chujoii/sumowar/README.org

#+OPTIONS: LaTeX:t          Do the right thing automatically (MathJax)
#+OPTIONS: LaTeX:dvipng     Force using dvipng images
#+OPTIONS: LaTeX:nil        Do not process LaTeX fragments at all
#+OPTIONS: LaTeX:verbatim   Verbatim export, for jsMath or so
#+ATTR_HTML: width="3in"

README.org --- description

Copyright (C) 2012 Roman V. Prikhodchenko

Author: Roman V. Prikhodchenko <chujoii@gmail.com>

  This file is part of sumowar.

  sumowar is free software: you can redistribute it and/or modify
  it under the terms of the GNU General Public License as published by
  the Free Software Foundation, either version 3 of the License, or
  (at your option) any later version.

  sumowar is distributed in the hope that it will be useful,
  but WITHOUT ANY WARRANTY; without even the implied warranty of
  MERCHANTABILITY or FITNESS FOR A PARTICULAR PURPOSE.  See the
  GNU General Public License for more details.

  You should have received a copy of the GNU General Public License
  along with sumowar.  If not, see <http://www.gnu.org/licenses/>.

* Keywords:
robot auto 

* Usage:
use it

* History:
Version 0.1 was created at 2013-05(May)-31

* Dependences:
  
* Description

** Название
sumowar [[./drawings/sumowar.png][sumowar ambigramm by chujoii]]
** Шасси

Основа робота - шасси с 4 ведущими и одновременно рулевыми
колёсами. Угол поворота каждого колеса задаётся серводвигателем (180
градусов). Поэтому робот может двигаться в любом направлении по
плоскости, и с любым радиусом разворота.

[[./drawings/chassis.png][sumowar chassis]]

Необходимо учитывать, что стандартные сервы (по крайней мере те
которые есть у меня) могут разворачивать только на 180 градусов, а в
некоторых случаях требуется реверсировать направление вращения
двигателей. Формулы для расчётов:

[[./drawings/motion.png][sumowar motion]]

*** Колёса

Колёса собраны по второй схеме:
[[./drawings/wheel.png][sumowar wheel]]
  
Из следующих компонентов:
[[./img/14020014.jpg][sumowar wheel components]]

- Крепёж скоба металлическая однолапковая D=25mm
- Подшипник с тонкими обоймами: от рулевой стойки 2108-09
  (C 2108-3401120-03) (размеры, как у 6805ZZ + пластиковая вставка)
- Алюминиевый профиль квадратный, наружный размер 15x15мм,
  внутренний размер 12x12мм (подходит для двигателя)
- 12V 200RPM Mini DC Metal Gear Motor Model:N20 (Sanyo) вот здесь я
  промахнулся с выбором - нужно было покупать 5-вольтовые двигатели
  и к ним drv8830
- покрышка для колеса подходящего диаметра

Внутрь подшипника устанавливается алюминиевый профиль и всё
закрепляется эпоксидкой (в проветриваемом помещении и в перчатках).
Самое сложное - сделать конструкцию соосной (не двигая головой,
добиться чтобы при вращении подшипника отражения внутри алюминиевого
профиля не наклонялись).

[[./img/14020037.jpg][sumowar wheel + epoxy + profile]]

*** Поворотный механизм
 
Скоба, маленький подшипник и пишущий узел от фломастера.

[[./img/14030007.jpg][sumowar bracer + ball bearing + felt-tip pen]]
  
На пластиковом основании (размеры отверстий соответствуют
пластиковому конструктору) крепятся подшипники.

[[./img/14030014.jpg][sumowar plate + ball bearing]]

С другой стороны приклеил держатели от банок с водой (розовые) и
подходящего диаметра крышки (синие) - они играют роль сервосейверов,
установщиков нуля (чтобы выставить поворот всех колёс одинаково) и
стоек на которых крепятся серводвигатели.

[[./img/14030006.jpg][sumowar bottle lid]]
  
Собираем всё вместе: 

[[./img/14030024.jpg][sumowar servo bracing]]

Припаиваем провода и керамический конденсатор (например k10-176
0.068uF U=50-100V), приклеиваем скобы на скотч, а также заклеиваем винт,
чтобы он не прокручивался в пишущем узле от фломастера.

*** Шасси в сборе

[[./img/14030032.jpg][sumowar wheel wire]]

Собираем всё вместе. На фотографии видны зажимы для бумаги - тоже
своеобразные сервосейверы - они с одной стороны приклеены к
покрышке, хорошо держатся на D-образном срезе оси двигателя, и
должны прощёлкивать при превышении усилия (однако, как оказалось
прощёлкивают даже при незначительном усилии и поэтому были сняты)

[[./img/14030037.jpg][sumowar chasis with servosaver]]

** Датчик линии

В качестве датчика линии - камера от оптической мыши.

Включена подсветка поверхности для видеокамеры из мыши. В качестве
объектива используется линза от CD-привода и дверной глазок.

[[./img/14050009.jpg][sumowar backlight]]

** Переворачиватель

Для участия в битве роботов установлен переворачиватель
противника. Пластиковая пластинка согнута под острым углом и играет
роль отвала (ножа). Внутрь полученного отвала установлен целофановый
пакет. При приближении противника лодочный насос (12v) нагнетает
воздух в целофановый пакет, он надувается примерно за секунду и
переворачивает робота противника. К сожалению, обычно, после этого
пакет лопается - нужно добавить датчик давления для контроля процесса
и отсос воздуха для многоразового использования. Эксперименты
проводились на пятилитровой банке с водой (по условиям конкурса вес
робота не более 3кг).

[[./drawings/obstacle.png][sumowar obstacle]]

** Вилочный подъёмник
  
Помимо переворачивалки предполагался вилочный подъёмник, однако
программная часть не была завершена вовремя и подъёмник не
установили.
[[./drawings/high-rise.png][sumowar high-rise]]

Одна из функций вилочного подъёмника - создание частичной
невидимости.

[[./drawings/invisible-and-military-dummy.png][sumowar invisible and dummy]]

** Первый слой
Вот как выглядит первый слой после сборки
(странности: фотография развёрнута):

[[./img/14050005.jpg][sumowar first level]]

- чёрная плата в середине - видеокамера из оптической мыши (там был
  ещё микроконтроллер для предварительной обработки изображения, но
  он не влез по размерам и был отрезан)
- самая верхняя и самая нижняя платы - L293 (знаю что не очень
  хорошие, но что было то и использовал)
- справа из под видеокамеры выглядывают конденсаторы для
  серводвигателей с самовосстанавливающимися предохранителями на
  200мА
- слева виден расширитель портов pcf8574 (выбор направления вращения
  для колёс) и шлейф (шина i2c + 1-wire + interrupt + reset)

* calculation
from http://www.robotshop.com/ca/learning-center/dynamic-tools.html

| INPUT                   |          |
|-------------------------+----------|
| Total mass of robot:    | 3 kg     |
| Number of drive motors: | 4 [#]    |
| Radius of drive wheel:  | 0.015 M  |
| Velocity of robot:      | 2 m/s    |
| Maximum incline:        | 30 [deg] |
| Supply voltage:         | 12 [V]   |
| Desired acceleration:   | 0.2 m/s2 |
| Desired operating time: | 15 min   |
| Total efficiency:       | 65 [%]   |

| OUTPUT  (per drive motor) |                                             |
|---------------------------+---------------------------------------------|
| Angular Velocity          | 133.33 rad/s                                |
| Torque*                   | 0.088356  Nm, 0.90067 kgf-cm, 12.511 ozf-in |
| Total Power               | 11.781 W                                    |
| Maximum current           | 0.98173 [A]                                 |
| Battery Pack              | 0.98173 [AH]                                |

| DC/V | RPM/min | torque kg.cm | Reduction ratio(1:00) |
|------+---------+--------------+-----------------------|
| 12V  |     300 |          0.6 |                   100 |
| 12V  |     200 |            1 |                   150 |
| 12V  |     100 |            2 |                   298 |
|      |         |              |                       |

* TechnoRoboCom
[2014-05-29] робот "sumowar" принял участие в конкурсе технологических
решений роботизированных устройств [[http://vk.com/club70185285][«TechnoRoboCom»]] .

[[./img/1auZE-fbeDQ.jpg][sumowar presentation]]

[[./img/LDUvZ1TbqBs.jpg][sumowar sumo]]

Один из основных этапов проекта - участие в конкурсе TechnoRoboCom
организованном Студенческим Бизнес Инкубатором (СБИ ПетрГУ).

В процессе работы в 2014 (второй семестр) году к проекту
присоединились студенты.

участники и их роли в проекте:

| Ф.И.О.                       | факультет                    | специальность (1013-2014 годы)                                                              | роль в проекте                                                                                                    |
|------------------------------+------------------------------+---------------------------------------------------------------------------------------------+-------------------------------------------------------------------------------------------------------------------|
| Бирюков Алексей Сергеевич    | физико-технический факультет | Теплоэнергетика и теплотехника курс:1 21115                                                 | создание платы драйвера шагового двигателя, вилочный погрузчик с отвалом, "Презентация"                           |
| Платонов Александр Сергеевич | физико-технический факультет | Теплоэнергетика и теплотехника курс:1 21115                                                 | создание платы драйвера шагового двигателя, вилочный погрузчик с отвалом, "Презентация"                           |
| Угрюмов Андрей Николаевич    | физико-технический факультет | Электропривод и автоматика промышленных установок и технологических комплексов курс:5 21505 | алгоритм "Битва роботизированных устройств", "Презентация"                                                        |
| Приходченко Роман Викторович | физико-технический факультет | Старший преподаватель                                                                       | всё остальное (закупки, механика, электроника, hal, алгоритм "Презентация", алгоритм "Трек", алгоритм "Лабиринт") |

** что он умеет делать

обсуждение на странице [[http://roboforum.ru/forum10/topic14343.html]]

Он ещё только учится :)

Подготовка отдельных модулей к соревнованию длилась около года.
Сборка была ужасной процедурой и заняла неделю. За оставшиеся два
дня были протестированы только алгоритмы движения колёс и обработка
изображения с видеокамеры.

На конкурсе работали только следующие режимы:

- Презентация.  Робот, не поворачиваясь вокруг оси, рисует звёздочку
  - проезжает по лучику и возвращается в центр.
    Потом вращается вокруг точек, которые генерируются в цикле.
    Координаты центров вращения расположены равномерно снаружи
    и внутри робота.
- Отслеживание линии. Робот распознаёт линию видеокамерой,
     проезжает по ней около метра и теряет её :( Буду дорабатывать
     алгоритм позже.
- Битва роботов. Не успел приделать датчики, алгоритм и вилочный
   подъёмник, поэтому был включён режим "презентации" с рисованием
   звёздочки и вращением. Робот выиграл два боя, случайно вытолкав
   противника с ринга во время танца  :oops:
  
Сейчас робота забрали на выставку :( 
Поэтому доделываю недоделки:  сканирующую систему для построения карты
и поиска противников.

*** Видео
  
  [[https://www.youtube.com/watch?v=cjYzR39-Q50]]
  выступление самовара с 2:26

  [[http://vk.com/video-60211626_169279477]]

* выводы

1. чтобы размещать платы стопками (как книги в шкафу) необходимо:
   
   печатные платы нужно делать с входами на одной стороне и выходами
   на другой стороне.
   
   совершенно недопустимо делать разъёмы на всех сторонах

2. на каждом этаже внутренней конструкции робота необходимо иметь
   "автономное" питание (свои GND, +5, +12)

3. каждый этаж должен соединяться со следующим ОДНИМ шлейфом (возможно
   составленным из проводов разного диаметра) чтобы можно было легко
   разъединять этажи

4. между устройствами (особенно между этажами) желательно использовать
   одну шину данных (i2c, 1-wire, ...), а не подключать каждое
   устройство напрямую к микроконтроллеру

5. ножки драйверов двигателей прижимать ?килоомным резистором к земле,
   а не оставлять болтаться как есть или подтягивать к питанию - чтобы
   при старте (в ту секунду между включением питания и инициализацией
   ножек микроконтроллера) двигатели не включались на полную скорость
