chujoii/sumowar/src/xbee.org

xbee.org --- how to use Xbee radio module; setup to rotation scanner

Copyright (C) 2013 Roman V. Prikhodchenko

Author: Roman V. Prikhodchenko <chujoii@gmail.com>

  This file is part of markerway.

  markerway is free software: you can redistribute it and/or modify
  it under the terms of the GNU General Public License as published by
  the Free Software Foundation, either version 3 of the License, or
  (at your option) any later version.

  markerway is distributed in the hope that it will be useful,
  but WITHOUT ANY WARRANTY; without even the implied warranty of
  MERCHANTABILITY or FITNESS FOR A PARTICULAR PURPOSE.  See the
  GNU General Public License for more details.

  You should have received a copy of the GNU General Public License
  along with markerway.  If not, see <http://www.gnu.org/licenses/>.

* connection to computer (FT232RL)

| ftdi | lilypad - zigbee |
|------+------------------|
| gnd  | gnd              |
| rx   | rx (not crossed) |
| tx   | tx (not crossed) |
| -    | 3.3 (external)   |

Air, Earth - Xbee Series 2

* AT-command

+++ 

** example 
   ATDT 1F<CR>
   | AT prefix | ASCII command | Space (optional) | Parameter (optional, HEX) | Carriage Return ('\r', 0x0D) |
   |-----------+---------------+------------------+---------------------------+------------------------------|
   | AT        | DT            |                  | 1F                        | <CR>                         |

| command | parameter | description                                                                               |
|---------+-----------+-------------------------------------------------------------------------------------------|
| ATBD    |         3 | read/write serial port speed 0:1200 1:2400 2:4800 3:9600 4:19200 5:38400 6:57600 7:115200 |
| ATID    |           | network identifier                                                                        |
| ---ATMY |           | node identifier MY sets the 16bit address                                                 |
| ATDH    |           | destination node identifier 64bit address                                                 |
| ATDL    |           | destination node identifier 64bit address                                                 |
|         |           |                                                                                           |
| ATND    |           | detect all nodes in network (обнаружить все узлы сети)                                    |
|         |           |                                                                                           |
| ATCN    |           | leave command mode                                                                        |
| ATWR    |           | write settings to firmware                                                                |

* string format
  Unix format Line feed LF ('\n', 0x0A)
  DOS format carriage_return + Line_feed CR+LF ('\r\n', 0x0D 0x0A)
  
  picocom --omap lfcr,delbs --imap crcrlf,bsdel --echo --baud 9600 /dev/ttyUSB0
  exit: C-a C-x 

* simple echo AT-mode
** earth configure
   "Coordinator AT"
   +++
   
   ATSH
   >>>> 123456
   
   ATSL
   >>>> ABCDEF12
   
   ;; ATID 3 ???????
   ATDH 123456
   ATDL ABCDEF01
   ATWR
   ATCN
   
** air configure
   "Router/end device AT"
   +++
   
   ATSH
   >>>> 123456
   
   ATSL
   >>>> ABCDEF01
   
   ;; ATID 7 ???????
   ATDH 123456
   ATDL ABCDEF12
   ATWR
   ATCN

   At air need connect "rx" and "tx"

** earth test work
   print "test" (without +++)

* adc API-mode

** earth configure
   "Coordinator API"

** air configure
   "Router/end device AT"
   
   +++
   ATD0 2 ;; enable ADC in pin D0
   ;; ATIR 0 ;; not need

** air testing from PC

   | command | description                                                                   |
   |---------+-------------------------------------------------------------------------------|
   | +++     | start                                                                         |
   |         |                                                                               |
   | ATD4 5  | LED "on"                                                                      |
   |         |                                                                               |
   | ATAC    | apply port state                                                              |
   |         |                                                                               |
   | ATIS    | read from photodiode dark current from ADC                                    |
   | > 01    | 1 byte ;; number of samples (in packet)                                       |
   | > 0010  | 2 byte ;; (Digital channel mask of) all digital pins reported on as list      |
   | > 01    | 1 byte ;; ADC D0 (analog channel mask of) all analog pins reported on as list |
   | > 0010  | 2 byte ;; D4 pin is on                                                        |
   | > 022D  | 2 byte ;; #x3FF == 1.2V   #x022D readed => (/ (* #x022D 1.2) #x3FF) = 0.65 V  |
   |         |                                                                               |
   | ATD4 4  | LED "off"                                                                     |
   |         |                                                                               |
   | ATAC    | apply port state                                                              |
   |         |                                                                               |
   | ATIS    | read from photodiode dark current from ADC                                    |
   | > 01    | 1 byte ;; number of samples (in packet)                                       |
   | > 0010  | 2 byte ;; (Digital channel mask of) all digital pins reported on as list      |
   | > 01    | 1 byte ;; ADC D0 (analog channel mask of) all analog pins reported on as list |
   | > 0000  | 2 byte ;; DO pin is off                                                       |
   | > 00CC  | 2 byte ;; #x3FF == 1.2V   #x00CC readed => (/ (* #x00CC 1.2) #x3FF) = 0.24 V  |
   |         |                                                                               |

* ultrasonic
  need use "Change Detection Sampling"

  | command | parameter | description                                                                                                                             |
  |---------+-----------+-----------------------------------------------------------------------------------------------------------------------------------------|
  | IR + IT |           | for sample rate                                                                                                                         |
  | IC      |           | to enable change detection on the input lines                                                                                           |
  | IA      |           | parameter controls permissions for other modules to order this module to change the states of its output lines.                         |
  | Tn + Dn |           | parameter (n in 0–7) sets timeout values for output lines whose values are set through I/O line passing (not through the IO parameter). |
  | PT      |           | parameter is a common timeout value for both analog outputs. (PWM)                                                                      |
  | IU      |           | parameter controls what happens to line state packets.                                                                                  |
