chujoii/sumowar/src/markerway/markerway-header.org

#+OPTIONS: LaTeX:t          Do the right thing automatically (MathJax)
#+OPTIONS: LaTeX:dvipng     Force using dvipng images
#+OPTIONS: LaTeX:nil        Do not process LaTeX fragments at all
#+OPTIONS: LaTeX:verbatim   Verbatim export, for jsMath or so
#+ATTR_HTML: width="10in"

% org-export-with-LaTeX-fragments

README.org --- description

Copyright (C) 2012 Roman V. Prikhodchenko

Author: Roman V. Prikhodchenko <chujoii@gmail.com>

  This file is part of markerway.

  markerway is free software: you can redistribute it and/or modify
  it under the terms of the GNU General Public License as published by
  the Free Software Foundation, either version 3 of the License, or
  (at your option) any later version.

  markerway is distributed in the hope that it will be useful,
  but WITHOUT ANY WARRANTY; without even the implied warranty of
  MERCHANTABILITY or FITNESS FOR A PARTICULAR PURPOSE.  See the
  GNU General Public License for more details.

  You should have received a copy of the GNU General Public License
  along with markerway.  If not, see <http://www.gnu.org/licenses/>.

* Keywords:
  robot auto 

* Description:

* Usage:
  use it

* Code:

У меня функции для работы с аппаратурой почти готовы.
Вам их писать не нужно. Ваша задача: сумо (бой роботов).

Вот список функций для получения данных и для отдачи команд роботу:

int set_wheels_straight (int angle, int desirable_linear_velocity)
{
   /*
   устанавливает движение робота по прямой линии.
   под углом angle = 0 .. 360, причём 90 градусов - движение вперёд.
   со скоростью desirable_linear_velocity = -255 .. 255.
   */
}

int set_wheels_rotate (int xt, int yt, int desirable_angular_velocity)
{
   /*
   x, y - координаты точки вращения относительно центра робота
          в ?миллиметрах? (миллиметры - потому, что
	  величины будут целыми,
	  сохранится большая точность,
	  размер максимального поля 32767мм~33метра - хватает для трассы).
   desirable_angular_velocity угловая скорость вращения.
   */
}

в любой момент вы можете прочитать массивы отсканированного
пространства, данные массивы обновляются автоматически (по прерываниям):

#define ir_hi_angle = 9 // углы в градусах
#define ir_hi_dimension = 40 // размер массива сейчас не известен (ещё не завершён) шаг двигателя 9 градусов -> 360/9 = 40
int ir_hi[ir_hi_dimension]; // данные инфракрасного датчика на башне

#define us_hi_angle = 9
#define us_hi_dimension = 40 
int us_hi[ir_hi_dimension]; // данные ультразвукового датчика на башне

#define us_lo_angle = 15
#define us_lo_dimension = 12 // размер массива сейчас не известен (нужны эксперименты) угол ультразвукового излучателя 15 градусов -> 180/15 = 12 или 24 для точности
int us_lo[ir_lo_dimension]; // данные ультразвукового датчика на бампере

#define line_sensor_dimension = 4
int line_sensor[line_sensor_dimension]; // инфракрасные датчики линии под каждым из четырёх колёс

#define button_sensor_dimension = 8
int button_sensor[button_sensor_dimension]; // кнопки по бокам робота с каждой стороны по две штуки

/*
        перед
        0    1

  7                 2
левый             правый 
борт              борт
  6                 3

        5    4
         зад

*/

// дополнительные функции:

int min_index(int p[], int dimension)
{
   /*
   вычисляет номер минимального элемента массива 
   */
}

int cycle_delay_ms = 10; // милисекунды

// у робота будет два оружия - отвал (спереди) и переворачивалка (сзади)
int bulldozer_blade(int f)
{
   поднять отвал с усилием f (0..255).
   результатом будет реальная высота поднятия (0..1023).
   очень сильно сажает батарейку - подняли, вытолкали за линию и выключили. если не удалось поднять за ~10 секунд, то тоже выключили. выключать нужно программно: bulldozer_blade(0);
}

int bulldozer_turn(int f)
{
   перевернуть с усилием f (0..255)
   результатом будет 0 (датчик отсутствует)
   очень сильно сажает батарейку - перевернули подержали так примерно ~10 секунд и выключили программно: bulldozer_turn(0);
}

если что забыл, то спрашивайте

У вас была правильно разделена программа на функции.
вот как примерно будет выглядеть ваша функция атаки (объявление предыдущих функций и констант не нужно, они уже есть):

void robosumo(){
   // найдём ближайшую цель - в реальности не сработает потому, что ближайшей целью скорее всего окажется нога зрителя
   int enemy_angle = min_index(ir_hi, ir_hi_dimension) * ir_hi_angle; // номер минимального элемента умножим на шаг в градусах получим угол расположения противника
   int speed = 255;
   int counter; // счётчик в цикле

   boolean all_white = true; //

   if (button_sensor[0] || button_sensor[1]){
      // он попался! раз коснулся переднего отвала
      bulldozer_blade(255); // не забудьте засечь время и выключить через ~10 секунд!
   }
   if (button_sensor[5] || button_sensor[6]){
      // он попался! раз коснулся задней переворачивалки
      bulldozer_turn(255); // не забудьте засечь время и выключить через ~10 секунд!
   }

   for (counter = 0; counter< line_sensor_dimension; counter++){
      // в цикле проверяем датчики линии под колёсами
      if (itisblack(line_sensor[counter])) { // если не дотягивает до белого, то оно чёрное
         all_white = false;
      }
   }   

   if (all_white) {
      // если все датчики линии показывают белый свет, то разворачиваемся (толкать лучше отвалом)
      // но закомментировано потому что одновременное движение и вращение описываются другими формулами (Трохоида - например удлинённая циклоида)
      // вы сперва повернитесь (например 3 секунды и только потом двигайтесь)
      // set_wheels_rotate (0, 0, 10); // 10 маленькая скорость

      // толкаем противника
      set_wheels_straight (enemy_angle, 255);

      // проверяйте лимит времени в 30 секунд:
      // если одно и тоже действие длится больше 30 секунд (проверить регламент), то засчитывается поражение! (либо ничья)
   } else {
      // раз коснулись линии то мы вытолкали противника и значит останавливаемся (скорость = 0)
      set_wheels_straight (enemy_angle, 0);
   }

   delay(cycle_delay_ms); // небольшая задержка нужна!
}

* code From: Андрей Угрюмов <w13w13@yandex.ru>

Subject: Re: функции.
Date: Tue, 27 May 2014 18:59:34 +0300
To: Roman V. Prikhodchenko <chujoii@gmail.com>

void analiz_koles(); 
/* анализируем датчики колес и если есть сигнал то прерываем всю программу, если возможно прервать программу программно (не по сигналу а по полученному значению) */

void vvod_parametrov();   
/*c клавиатуры вводим режим (номер) "трус" "лабиринт" и т. п.   и сторону на которой стоим.*/

void poisk_sprava();
/* используем все датчики с этой стороны, а потом из масива выискиваем самое маленькое значение. отправляем данные в функции движения (функция для setup)*/

void poisk_sleva();
   /* используем все датчики с этой стороны, а потом из масива выискиваем самое маленькое
       значение. отправляем данные в функции движения (функция для setup) */
       na_vraga();

void poisk_vsemi();
  /* используем все датчики (функция для loop) 
      ищем самое малое b*/
      na_vraga();

void na_vraga();
/* поворачиваемся по данным поиска и начинаем движение на врага */

void ataka_pered();
/* контрольная проверка если расстояние меньше 50-80 мм то это враг. используем оружие */

void ataka_zad();
/* контрольная проверка если расстояние меньше 50-80 мм то это враг. используем оружие */

void setup();
{ //1 
rejim=0;

do 
vvod_parametrov /* вызывать функцию считывания параметров*/
while (0<rejim)

switch (rejim)  // используем значение из функции vvod_parametrov

  {  //2
     case 1:

   /* задаем движение вокруг центра круга */
   /* после определение с каких датчиков начать надо дать ему время на анализ,*/

   switch (storona)  // используем значение из функции vvod_parametrov
       { //3
        case 1:
           poisk_sleva()
           break;

        case 2:
           poisk_sprava();
           break;
     /* даем время на то чтоб отъехать от края в сторону врага или продолжить движение (но он
        должен найти кого нить)*/
         } //3
     break;
   } //2
} //1

void loop();
{ //1
  switch (rejim)  // используем значение из функции vvod_parametrov
     { //2
      case 1: // пусть это режим "бойца", (ничего не боимся).
            analiz_koles();
            poisk_vsemi(); // по идее должна подтвердить положение врага или скоректировать курс 
            ataka_pered();
            ataka_zad();
            
         break;
      case 2:
        
         break;
     } //2
} //1

* code ответ Роман Приходченко

//void analiz_koles(); 
int analiz_koles()
{
   /* анализируем датчики колес и если есть сигнал то прерываем всю
      программу, если возможно прервать программу программно (не по
      сигналу а по полученному значению)
   */
   
   /* АНАЛИЗ колёс предполагает какой-то вывод поэтому, вместо void,
      возможно, лучше подойдёт int (это зависит от логики которую вы
      закладываете в программу, так что может быть стоит оставить
      void? - вам решать)

      например:
      0 - все колёса на белой бумаге
      1 - одно колесо на чёрной линии
      и так далее 

      расположение колёс (загадка: почему такая странная нумерация? ответ в рисунках к проекту)

        отвал
        перед
        1    3

        0    2
         зад
    переворачивалка

      состояние колёс можно получить так:
   */
   
   boolean sens0 = get_wheel_line_sensor(0);
   boolean sens1 = get_wheel_line_sensor(1);
   boolean sens2 = get_wheel_line_sensor(2);
   boolean sens3 = get_wheel_line_sensor(3);
   
   // если sensX == 1 == true    значит на чёрной линии
   // если sensX == 0 == false   значит на белой бумаге

   // а обработка на вас. далее пример:
   int result = 0;

   if (sens0 == true){
       // тут примерный код для обработки касания чёрной линии
       result++;
   }
   if (sens1 == true){
       // тут примерный код для обработки касания чёрной линии
       result++;
   }
   if (sens2 == true){
       // тут примерный код для обработки касания чёрной линии
       result++;
   }
   if (sens3 == true){
       // тут примерный код для обработки касания чёрной линии
       result++;
   }
   
   return result;
}

void vvod_parametrov();   
/*c клавиатуры вводим режим (номер) "трус" "лабиринт" и т. п.   и сторону на которой стоим.*/

// эту функцию я напишу. результат в переменной "rejim"
// сколько вариантов вы осилите? я думаю 2 варианта нормально rejim=0 и rejim=3 (1 и 2 оставить на будущее)
// rejim = 0 трус 
// rejim = 1 ??????
// rejim = 2 ????????
// rejim = 3 агрессивный

int poisk_sprava(){
/* используем все датчики с этой стороны, а потом из масива выискиваем самое маленькое значение. отправляем данные в функции движения (функция для setup)*/

 /* эта функция на вашей совести :)
 
 я напишу функцию
 int get_distance_from_left_sensor(int angle);
 которая возвращает расстояние с левого датчика,
 а вы ей пользуйтесь, например:
*/
   int angle;
   int distance;
   int enemy_angle=0; // начальный угол до врага
   int enemy_distance=get_distance_from_left_sensor(0); // начальное расстояние до врага
   
   for (angle=0; angle<180; angle=angle+7){
      result = get_distance_from_left_sensor(angle);
      if (result<enemy_distance){
         enemy_angle=angle;
	 enemy_distance=result;
      }
   }
   // тут возможно будут ещё некоторые действия
   return enemy_angle;
}

остальные заготовки функций подойдут.

Функции "setup" и "loop" нужно будет немного подправить, когда я
доделаю свою часть работы, чтобы был выбор: трек, лабиринт, бой.
Я потом пришлю пример.

кстати там в номерах датчиков была ошибка. теперь они выглядят так:

        отвал
        перед
        0    1

  7                 2
левый             правый 
борт              борт
  6                 3

        5    4
         зад
     переворачивалка
