chujoii/sumowar/drawings/chassis.png

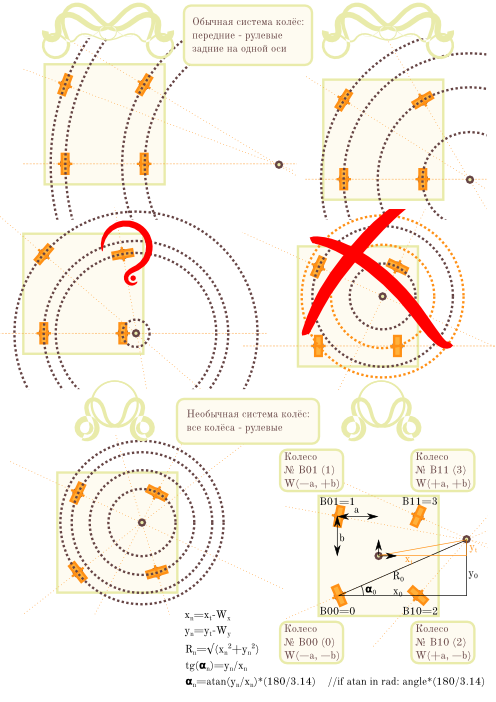
drawings/chassis.png
