chujoii/sumowar/drawings/high-rise.png

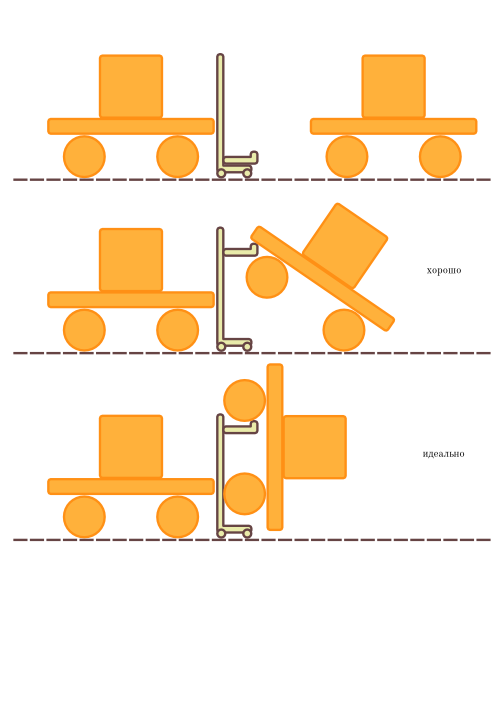
drawings/high-rise.png
