chujoii/sumowar/drawings/invisible-and-military-dummy.png

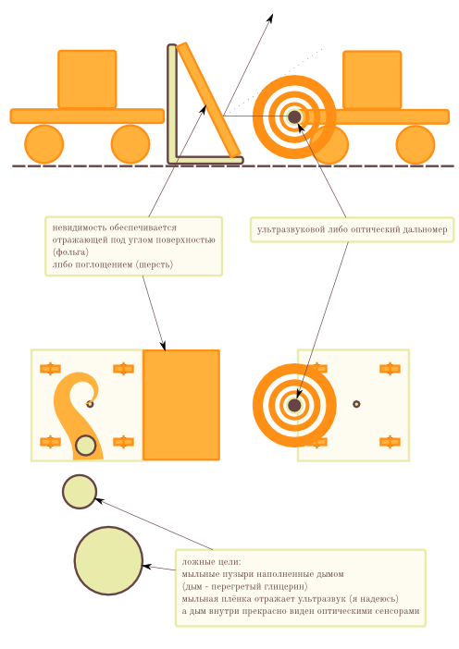
drawings/invisible-and-military-dummy.png
