chujoii/sumowar/drawings/motion.png

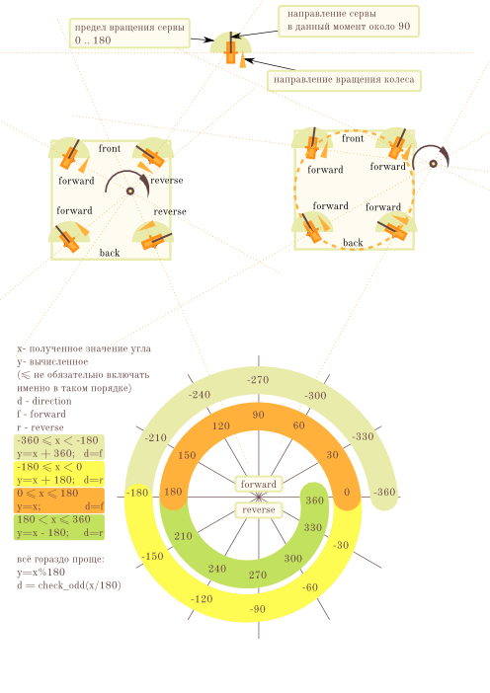
drawings/motion.png
