chujoii/sumowar/drawings/obstacle.png

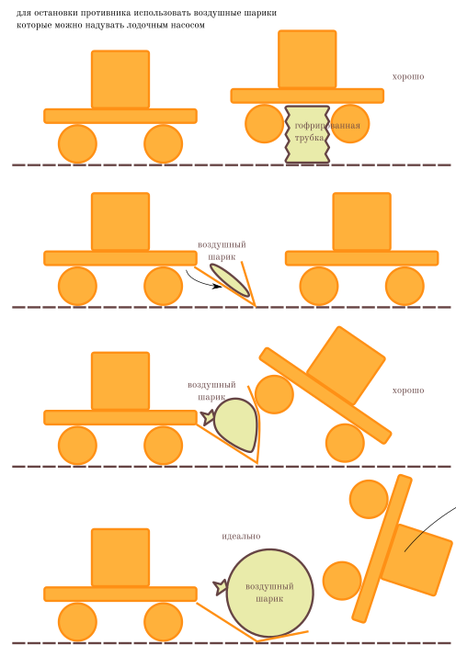
drawings/obstacle.png
