chujoii/sumowar/drawings/sumowar.png

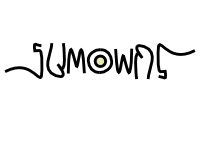
drawings/sumowar.png
