chujoii/sumowar/drawings/wheel.png

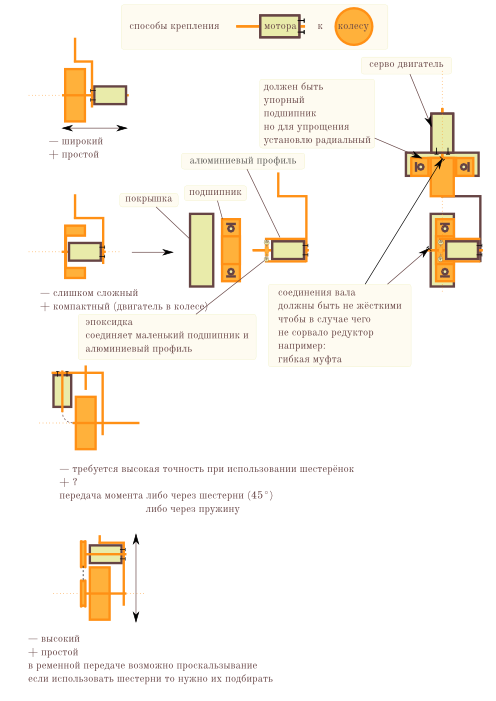
drawings/wheel.png
