chujoii/sumowar/img/1auZE-fbeDQ.jpg

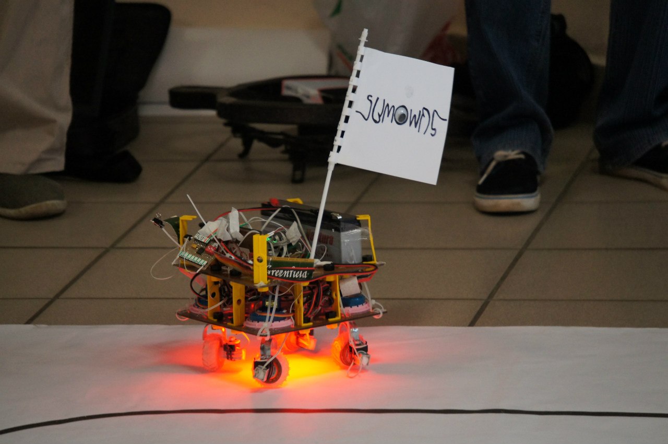
img/1auZE-fbeDQ.jpg
