chujoii/sumowar/img/13060001.png

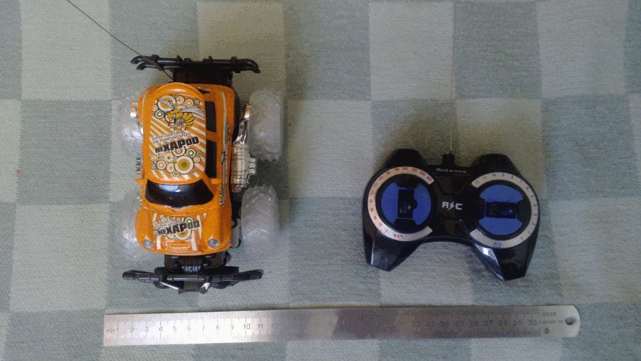
img/13060001.png
