chujoii/sumowar/img/13060002.png

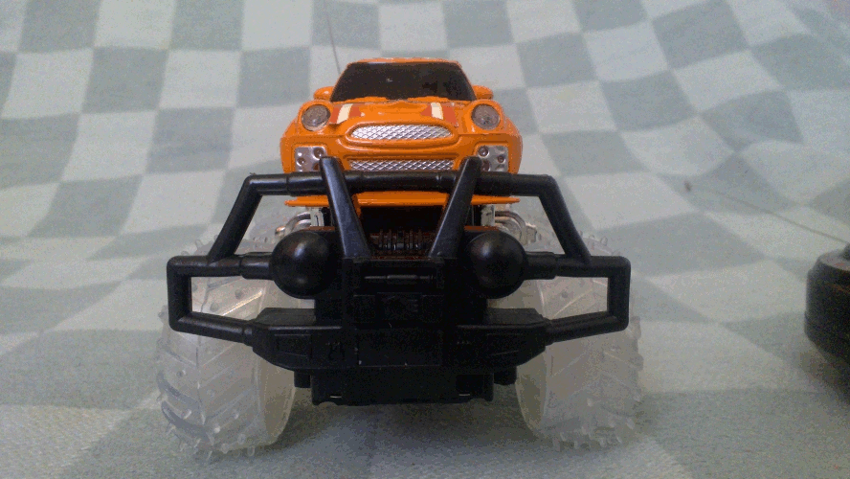
img/13060002.png
