chujoii/sumowar/img/13060003.png

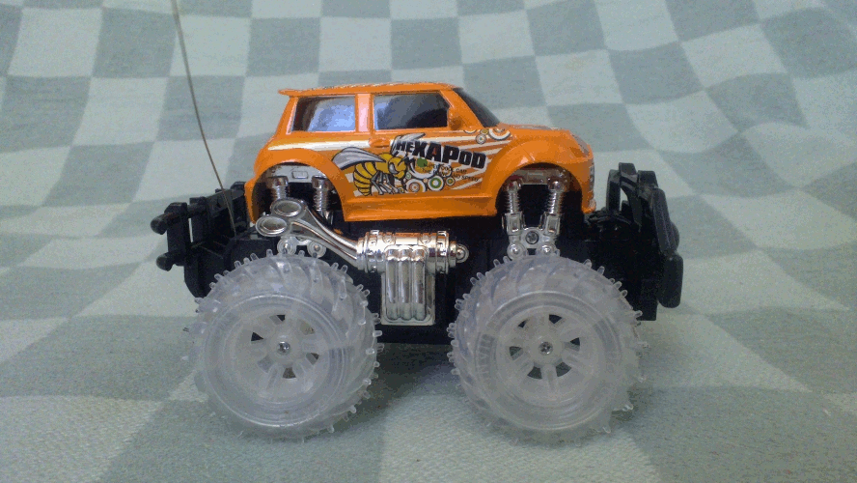
img/13060003.png
