chujoii/sumowar/img/13060004.png

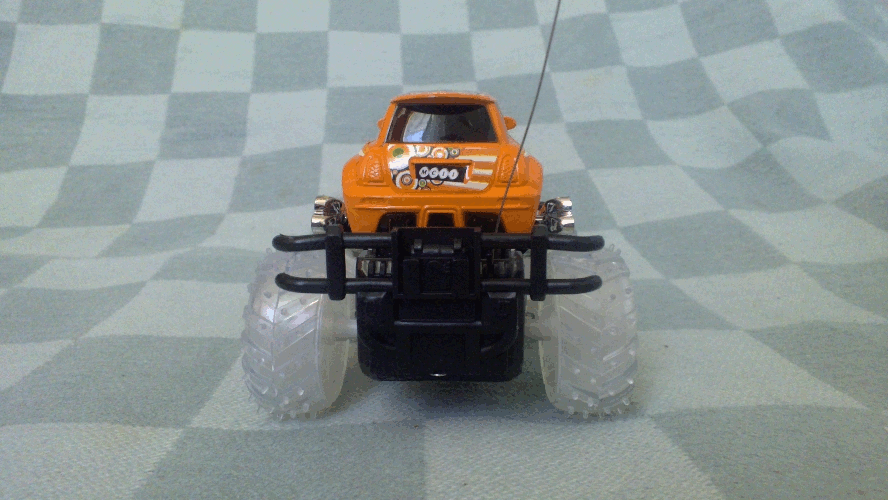
img/13060004.png
