chujoii/sumowar/img/13060008.png

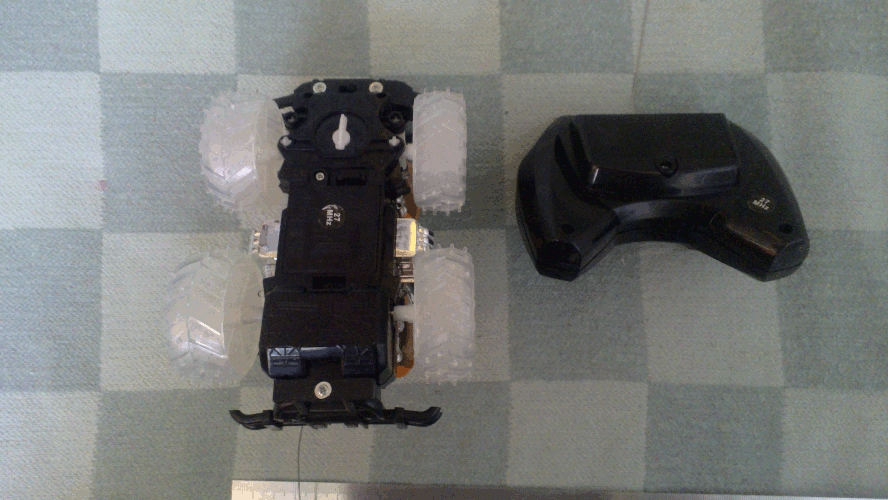
img/13060008.png
