chujoii/sumowar/img/13080001.png

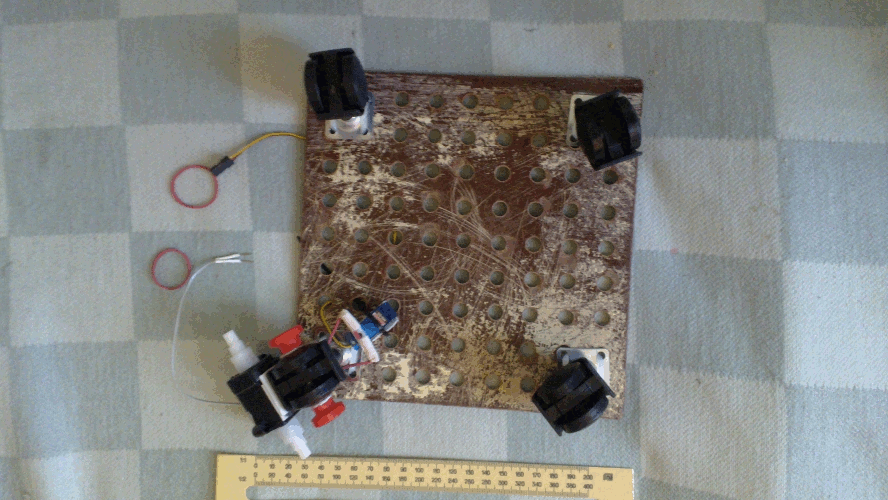
img/13080001.png
