chujoii/sumowar/img/13080002.png

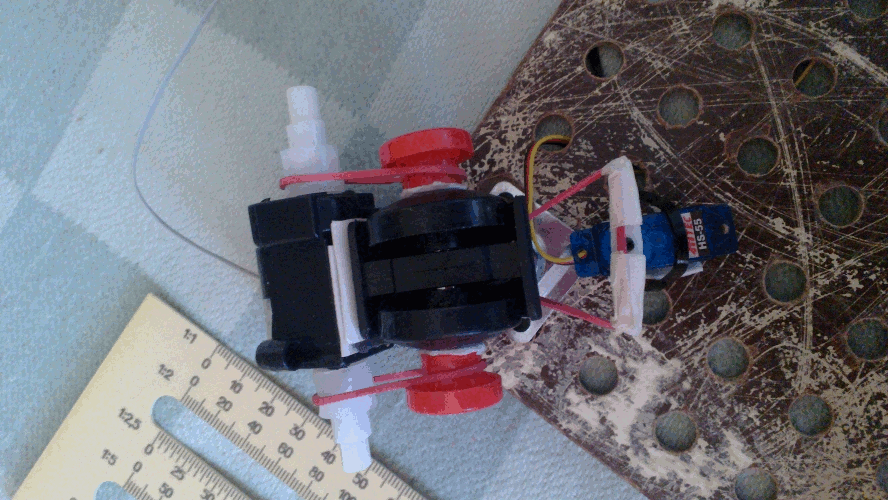
img/13080002.png
