chujoii/sumowar/img/13080003.png

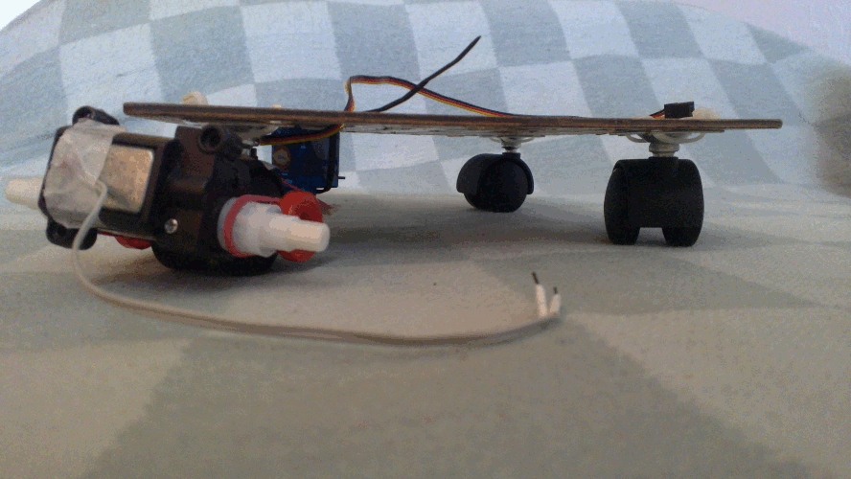
img/13080003.png
