chujoii/sumowar/img/13080004.png

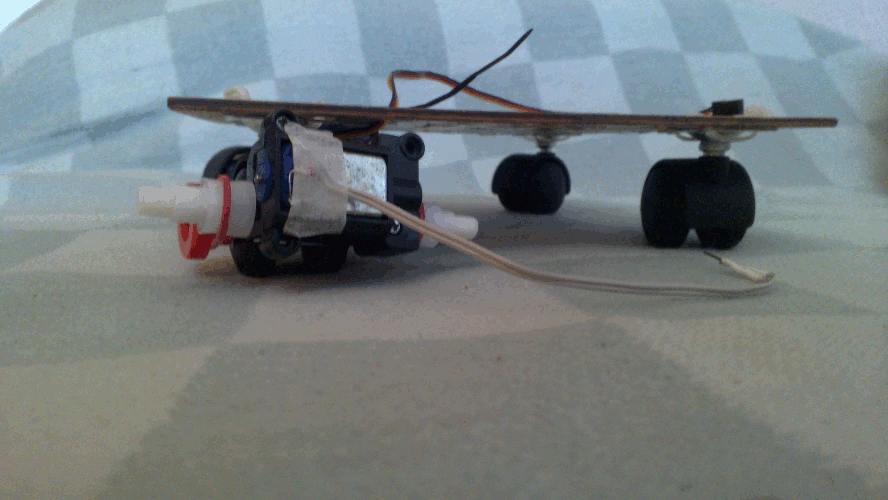
img/13080004.png
