chujoii/sumowar/img/13080005.png

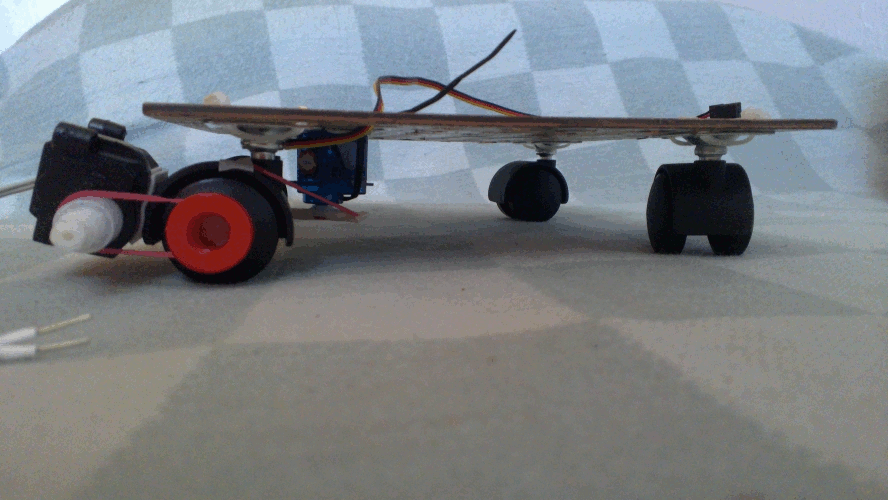
img/13080005.png
