chujoii/sumowar/img/13080006.png

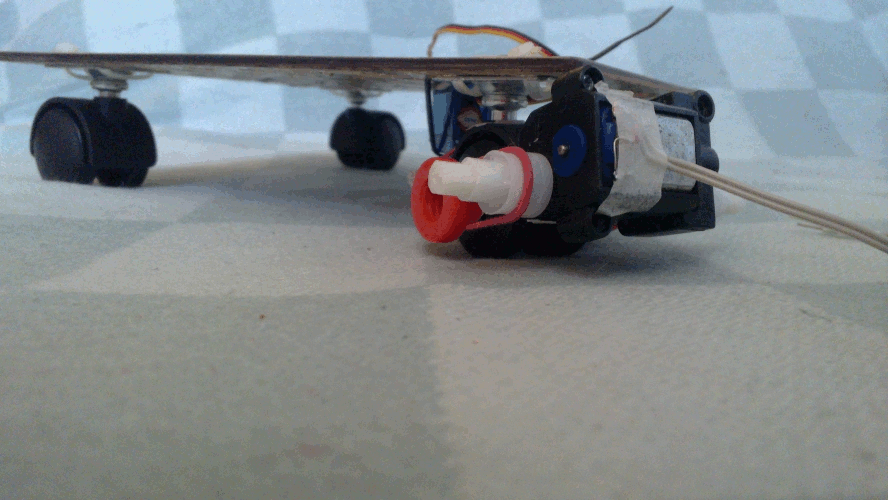
img/13080006.png
