chujoii/sumowar/img/13080007.png

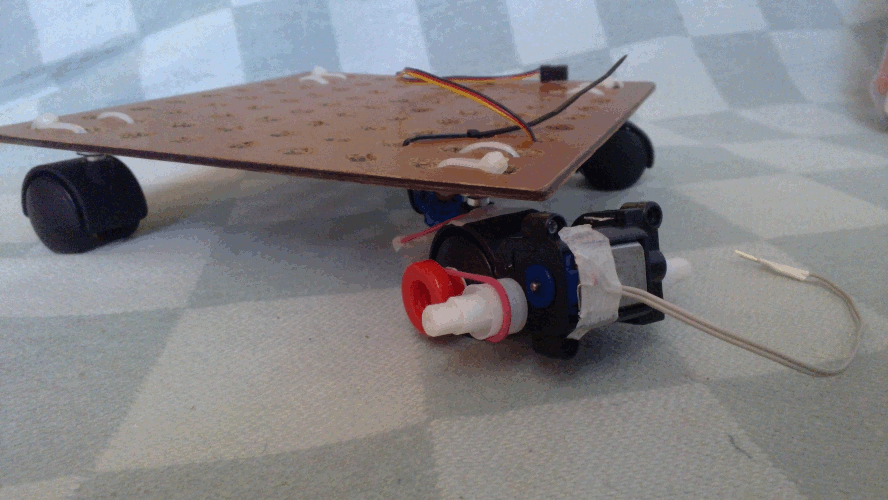
img/13080007.png
