chujoii/sumowar/img/13080009.png

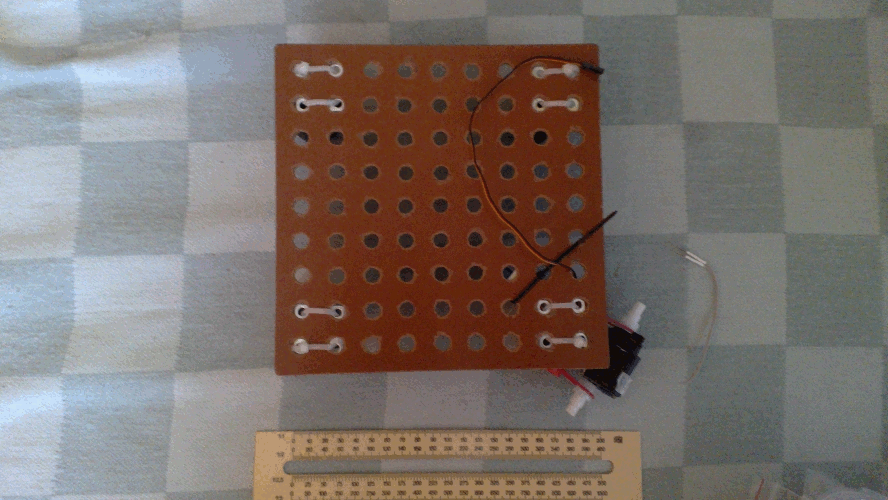
img/13080009.png
