chujoii/sumowar/img/13090006.png

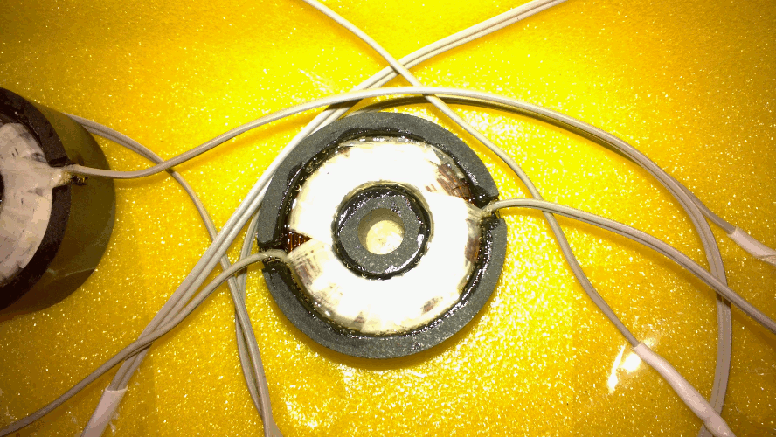
img/13090006.png
