chujoii/sumowar/img/13090052.png

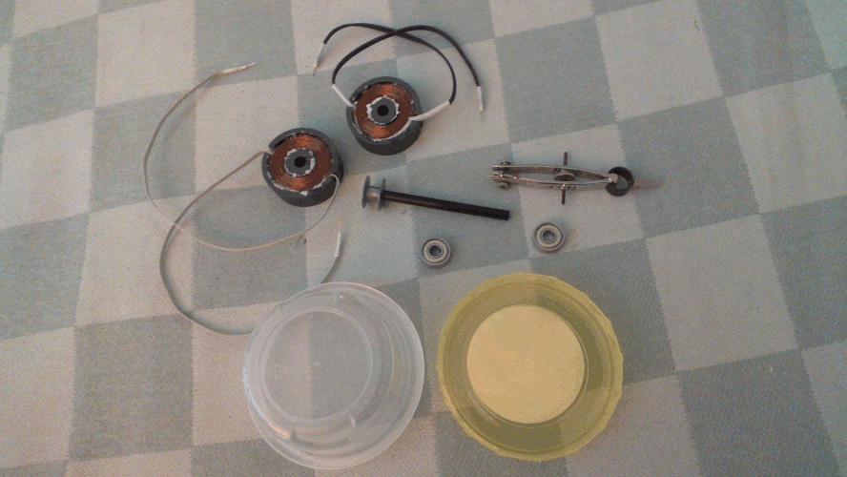
img/13090052.png
