chujoii/sumowar/img/13090054.png

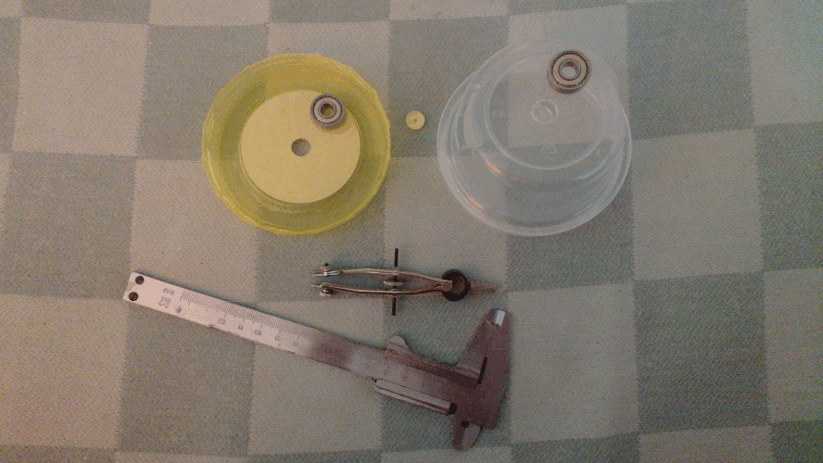
img/13090054.png
