chujoii/sumowar/img/13090055.png

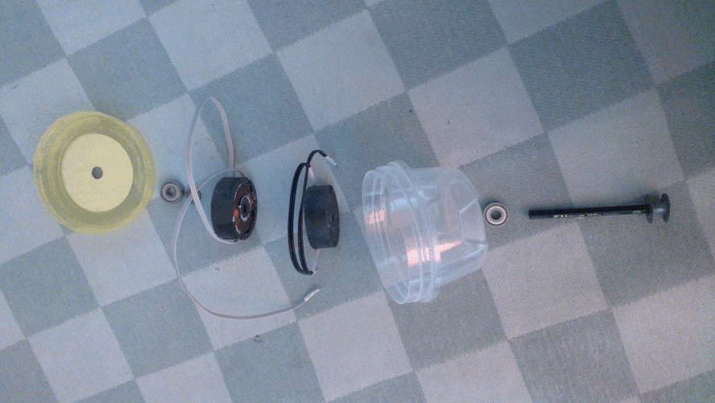
img/13090055.png
