chujoii/sumowar/img/14020014.jpg

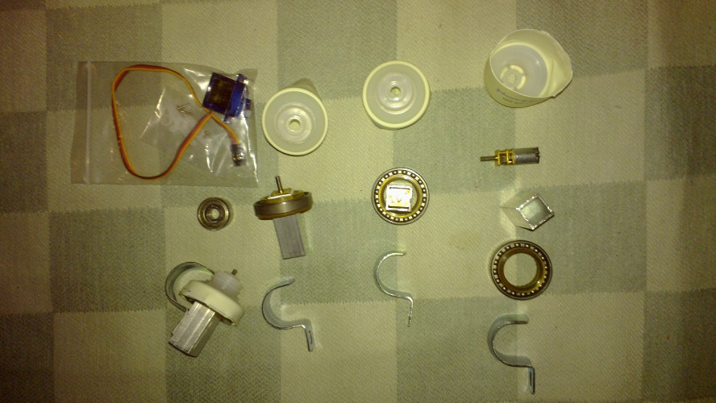
img/14020014.jpg
