chujoii/sumowar/img/14020037.jpg

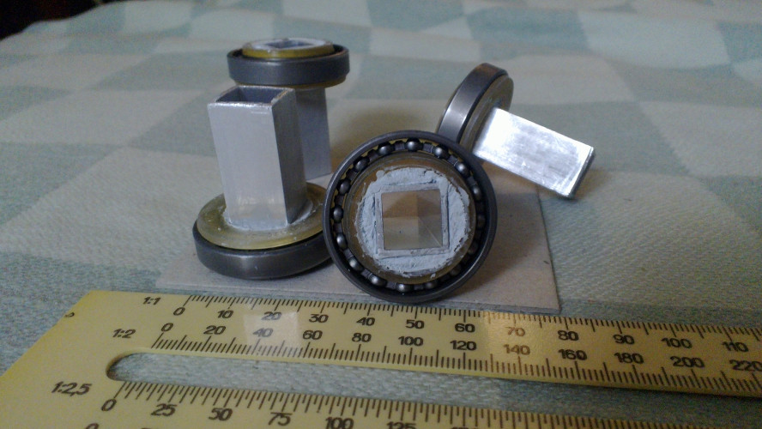
img/14020037.jpg
