chujoii/sumowar/img/14030006.jpg

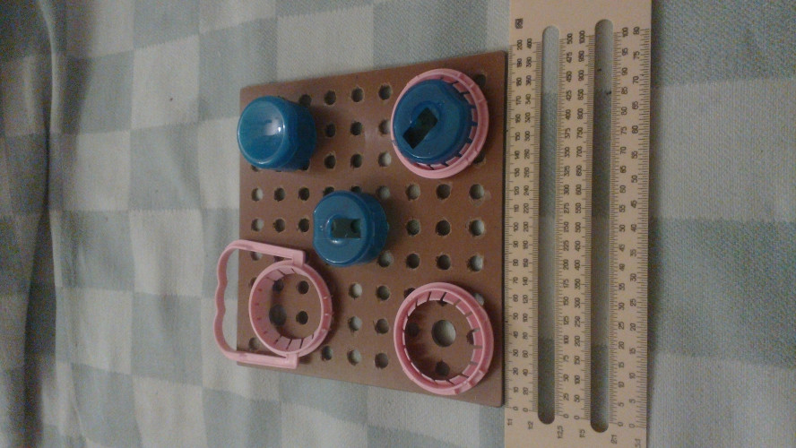
img/14030006.jpg
