chujoii/sumowar/img/14030007.jpg

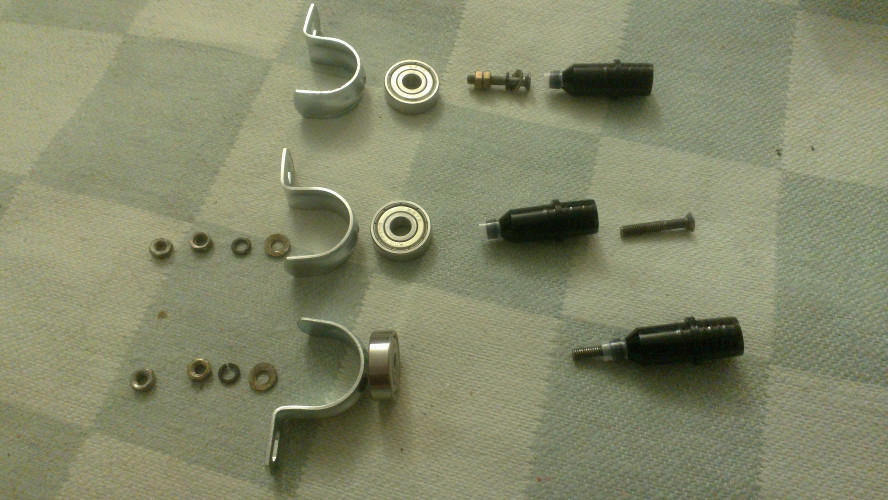
img/14030007.jpg
