chujoii/sumowar/img/14030013.jpg

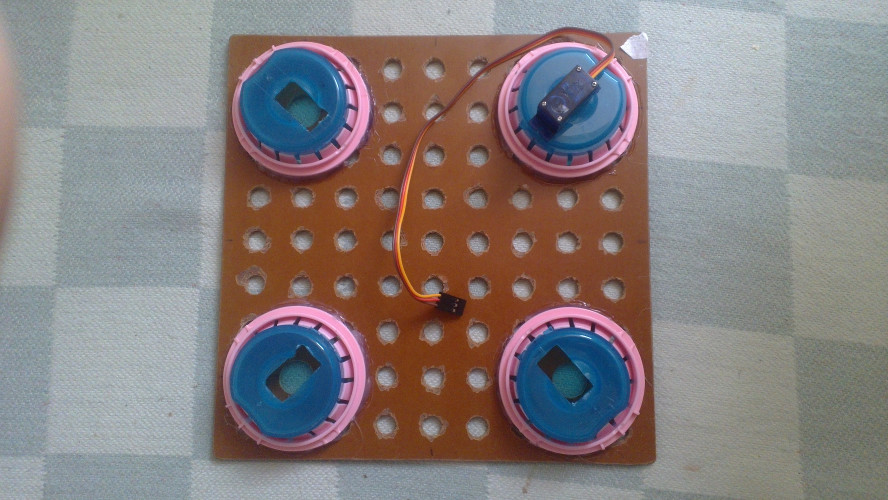
img/14030013.jpg
