chujoii/sumowar/img/14030014.jpg

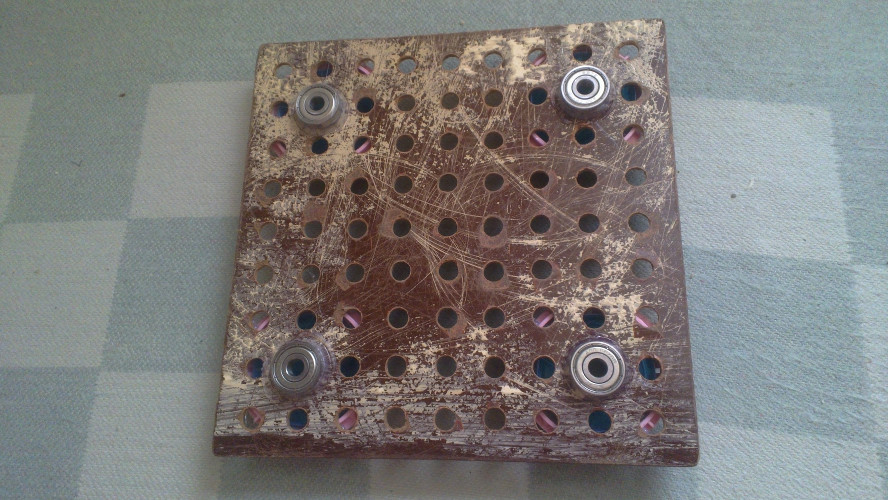
img/14030014.jpg
