chujoii/sumowar/img/14030024.jpg

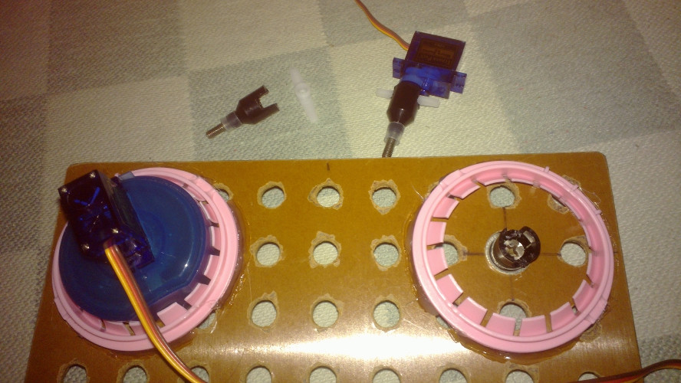
img/14030024.jpg
