chujoii/sumowar/img/14030032.jpg

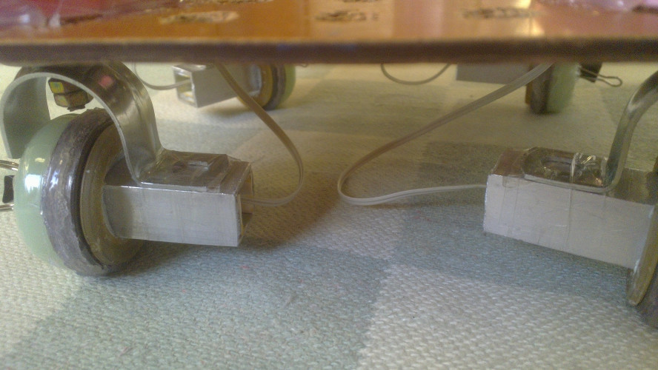
img/14030032.jpg
