chujoii/sumowar/img/14030037.jpg

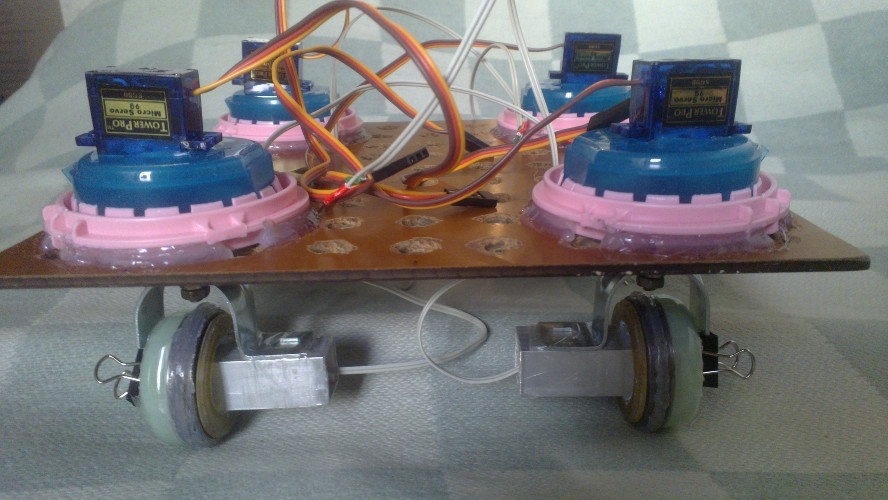
img/14030037.jpg
