chujoii/sumowar/img/14040004.jpg

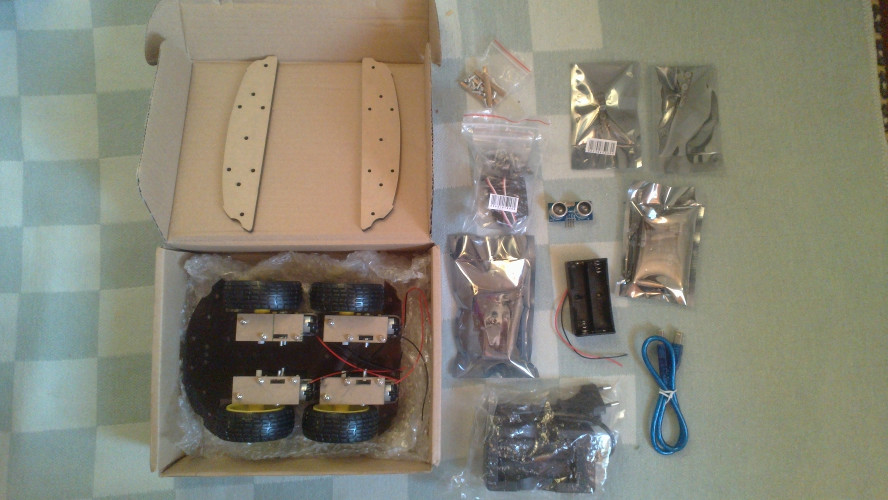
img/14040004.jpg
