chujoii/sumowar/img/14040005.jpg

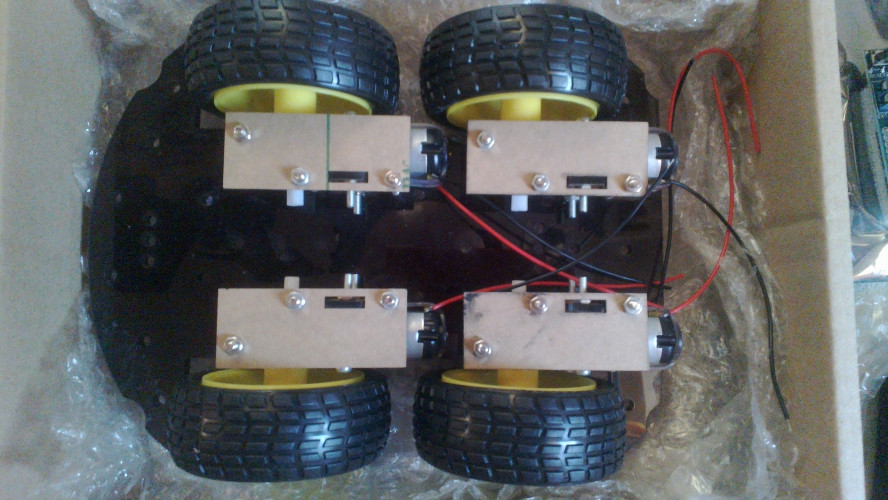
img/14040005.jpg
