chujoii/sumowar/img/14040006.jpg

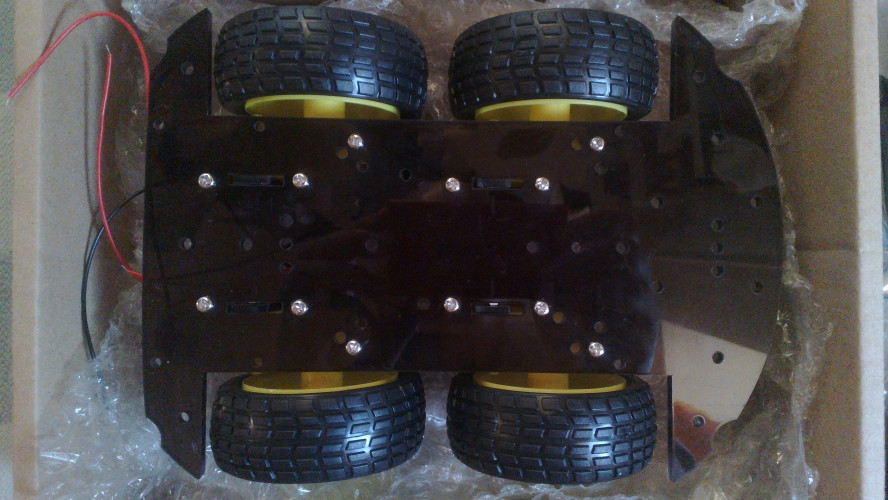
img/14040006.jpg
