chujoii/sumowar/img/14040007.jpg

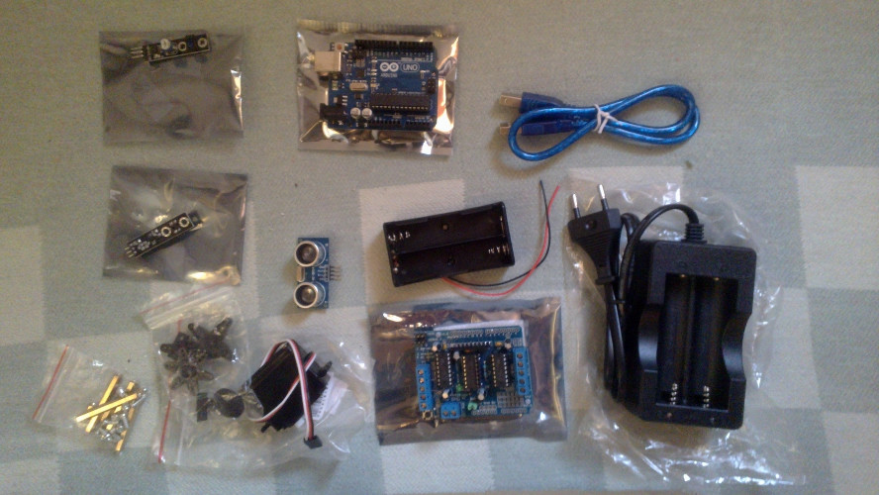
img/14040007.jpg
