chujoii/sumowar/img/14040013.jpg

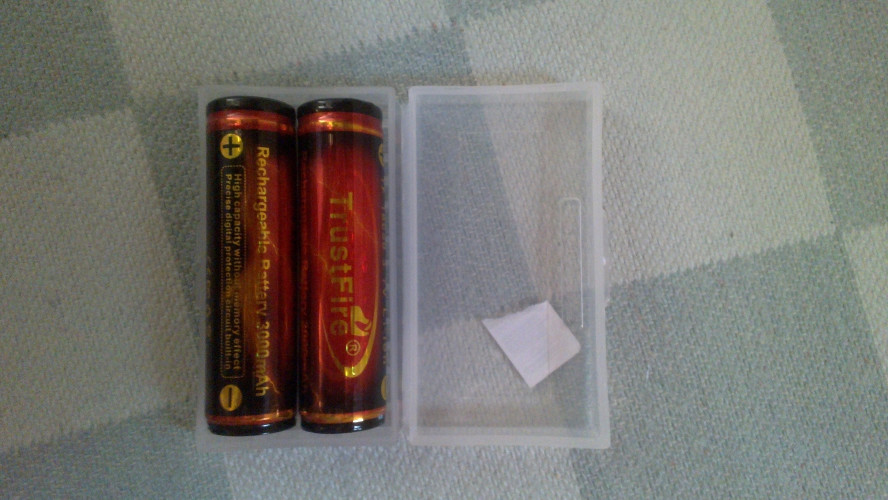
img/14040013.jpg
