chujoii/sumowar/img/14050005.jpg

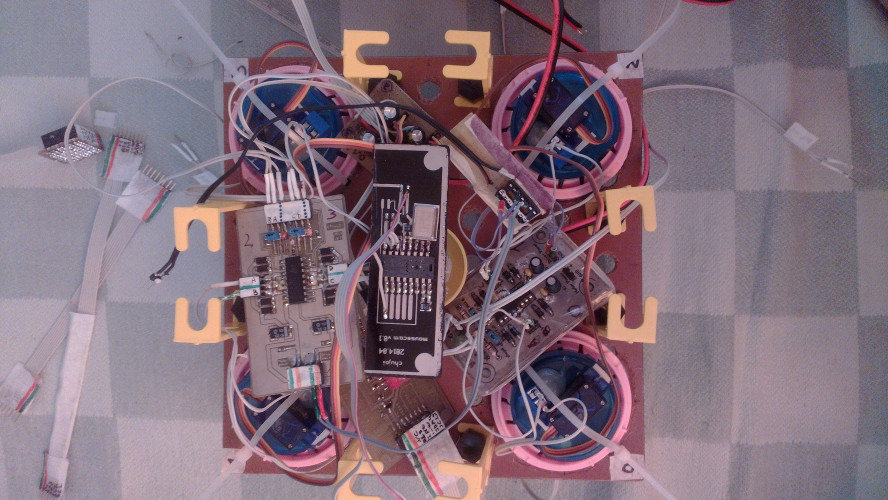
img/14050005.jpg
