chujoii/sumowar/img/14050006.jpg

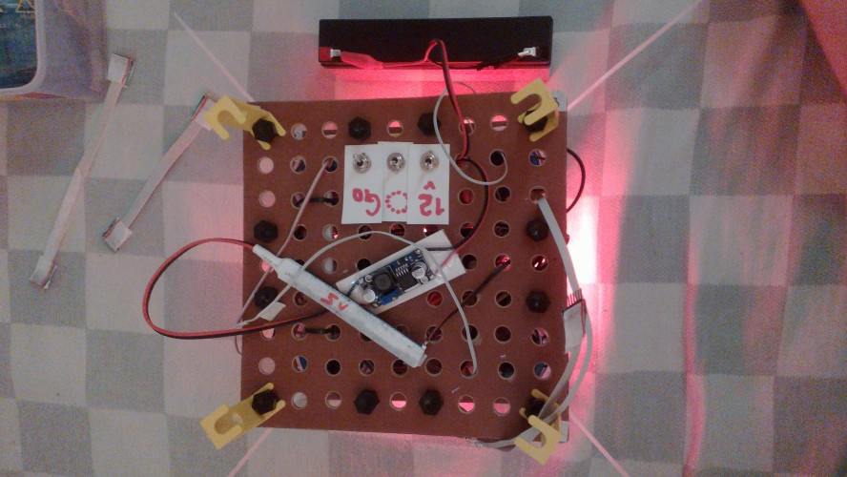
img/14050006.jpg
