chujoii/sumowar/img/14050007.jpg

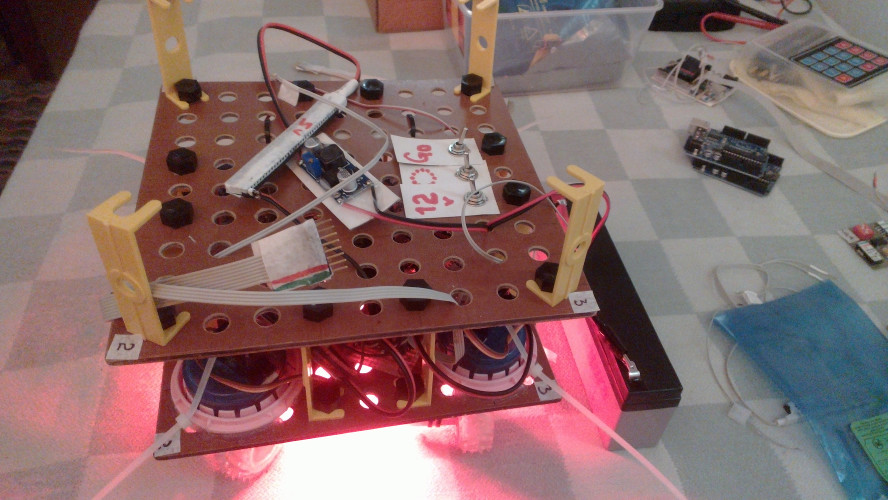
img/14050007.jpg
