chujoii/sumowar/img/14050008.jpg

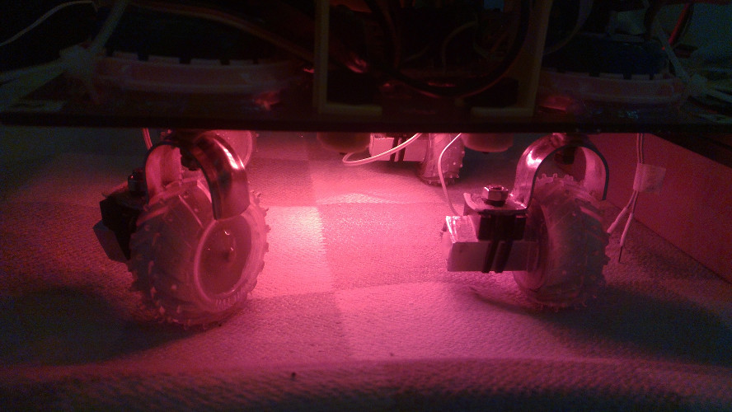
img/14050008.jpg
