chujoii/sumowar/img/14050009.jpg

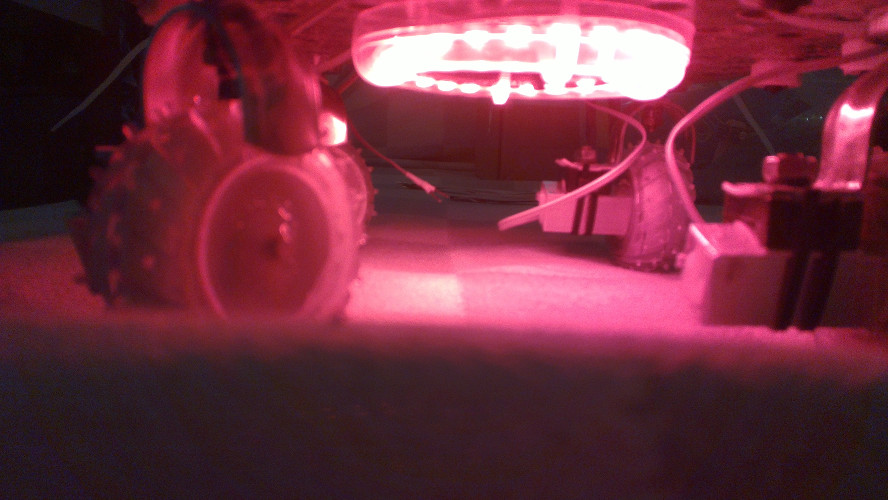
img/14050009.jpg
