chujoii/sumowar/img/LDUvZ1TbqBs.jpg

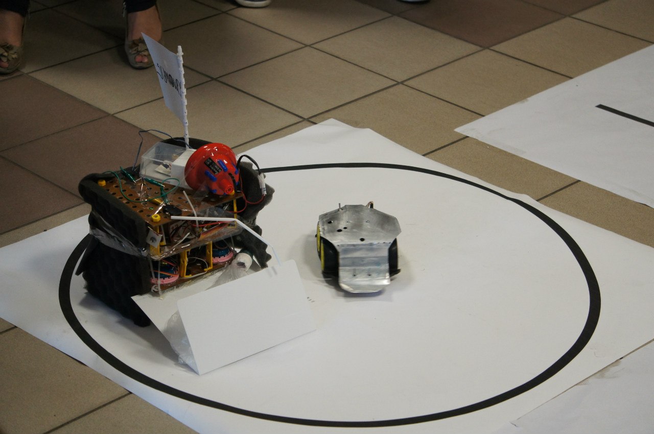
img/LDUvZ1TbqBs.jpg
