chujoii/sumowar/(commit log)

2013-06-30 2013-06(Jun)-30 rotatory sensor
2013-08-12 remove debug print
2013-08-30 weighting and motor calculations
2013-08-31 chassis for markerway
2013-09-05 Sanyo micro metal gearmotor brushed choise
2014-01-21 wheel motion (servo + gearmotor)
2014-02-20 new chassis
2014-02-21 ball bearing + epoxy + aluminum profile
2014-03-17 servo saver
2014-03-20 chassis assembly
2014-05-28 fix strange error with wheel (confuse wire for PWM-speed control for 1 and 2 wheel)
    [markerway.ino, sumowarrior.ino]
2014-05-28 ambigram: "sumowar" = самовар [ru] = sumo + war
2014-05-28 split program to markerway.ino (main) and chassis.ino
2014-06-14 air pump and suction
